tim-fan/vio_hardware/doc/rovio_trajectory_300m.png

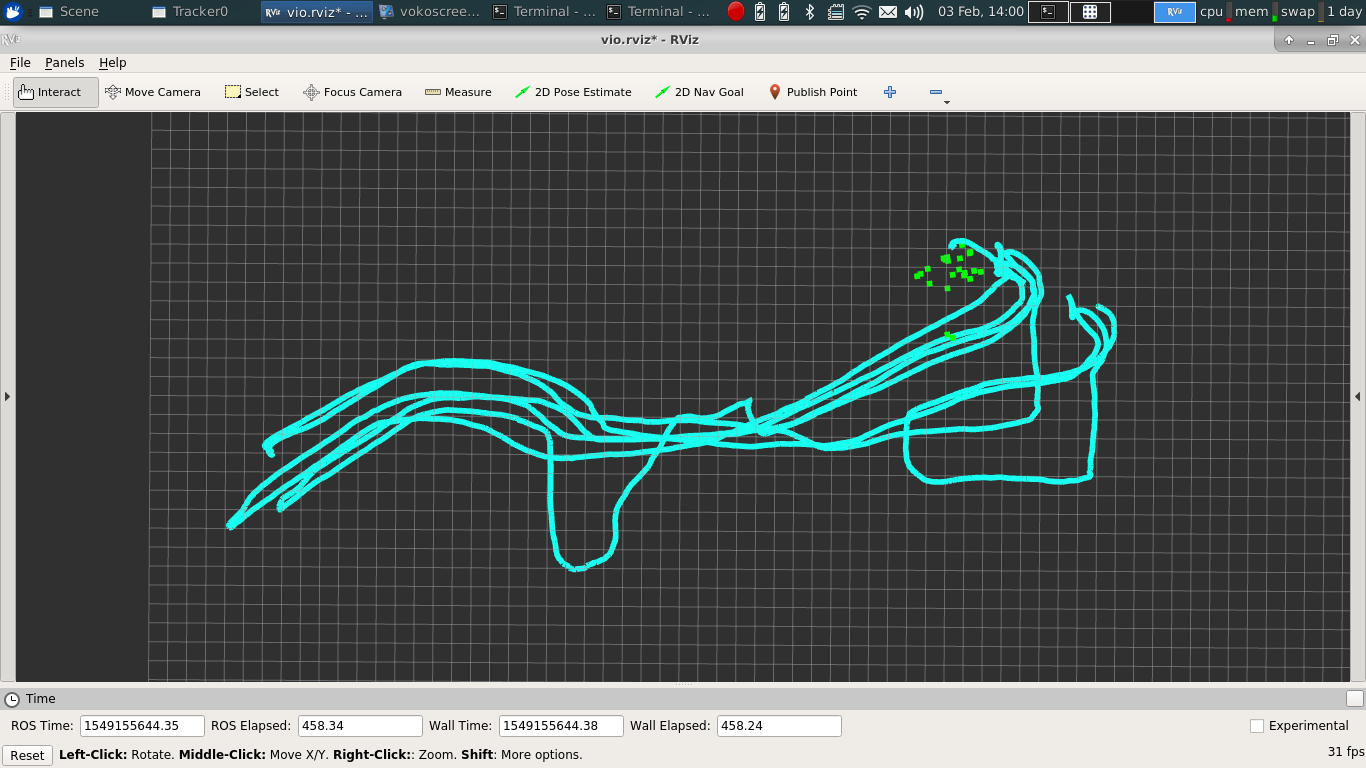
doc/rovio_trajectory_300m.png
