tim-fan/vio_hardware/doc/timestamp_corrections.png

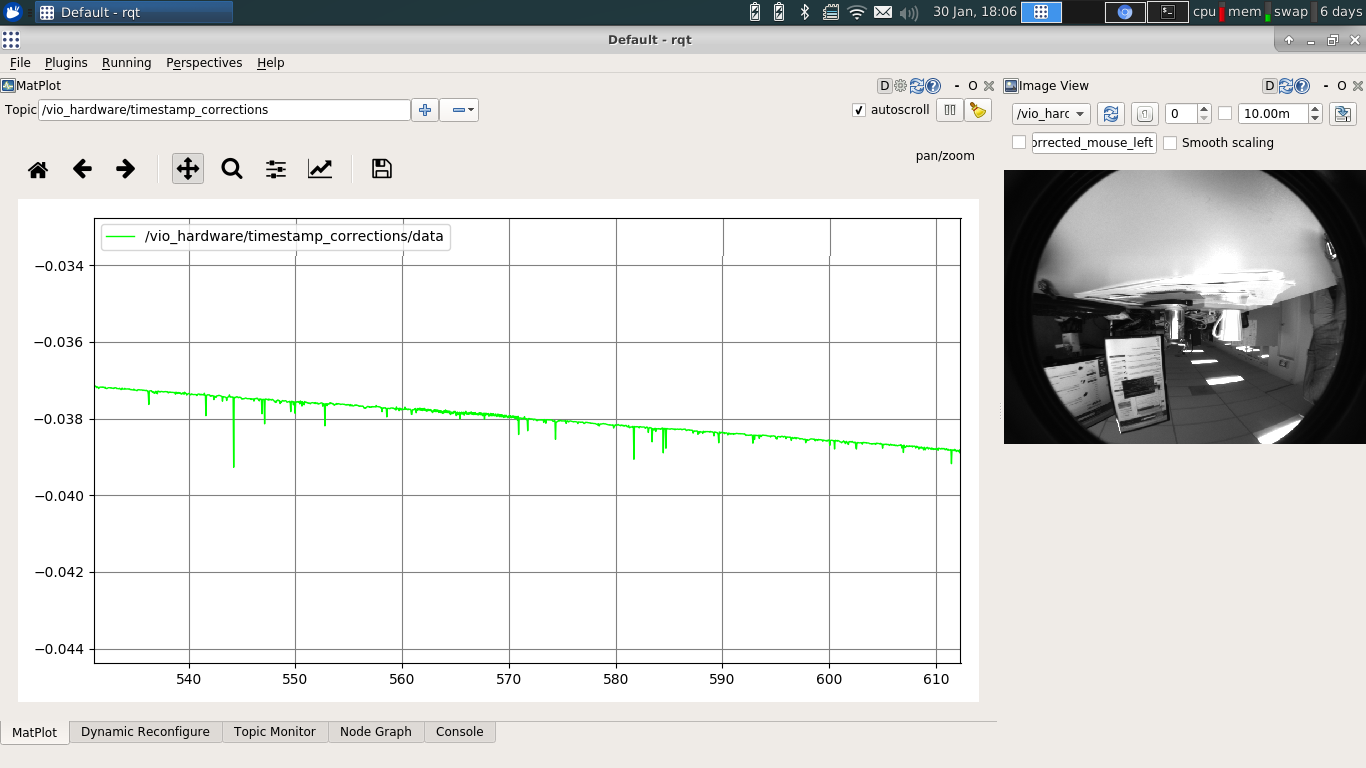
doc/timestamp_corrections.png
