tim-fan/vio_hardware/doc/kalibr_results/report-cam-vio_calibration_log_2019-02-01-18-13-28.pdf

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

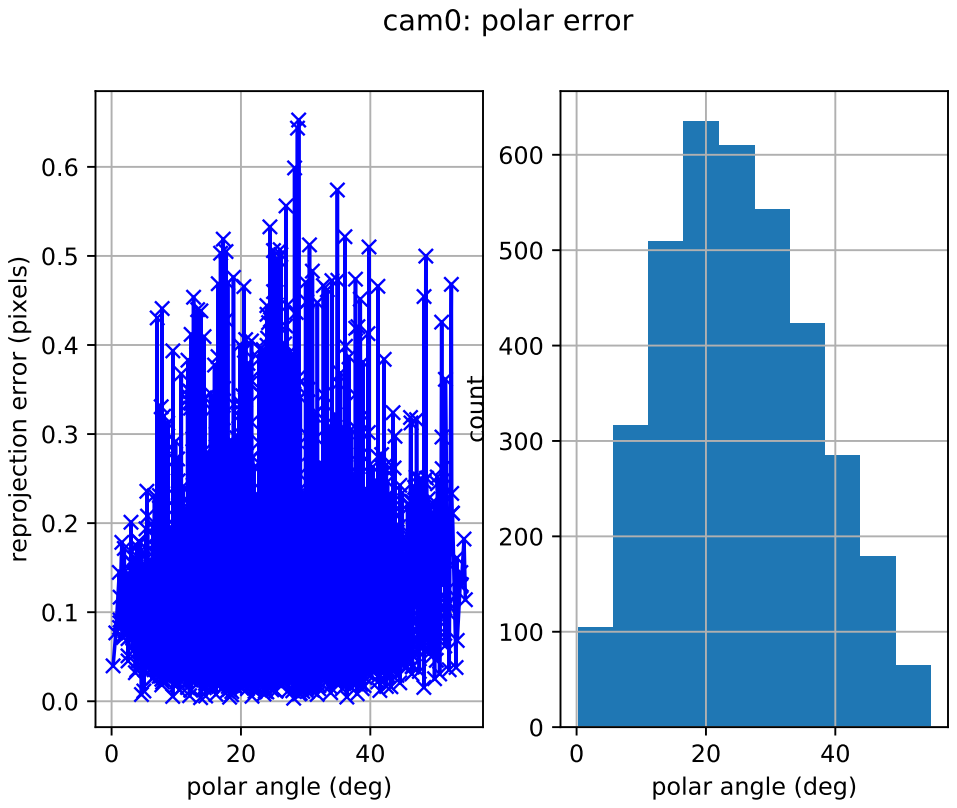
[picture p5: page 1]

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

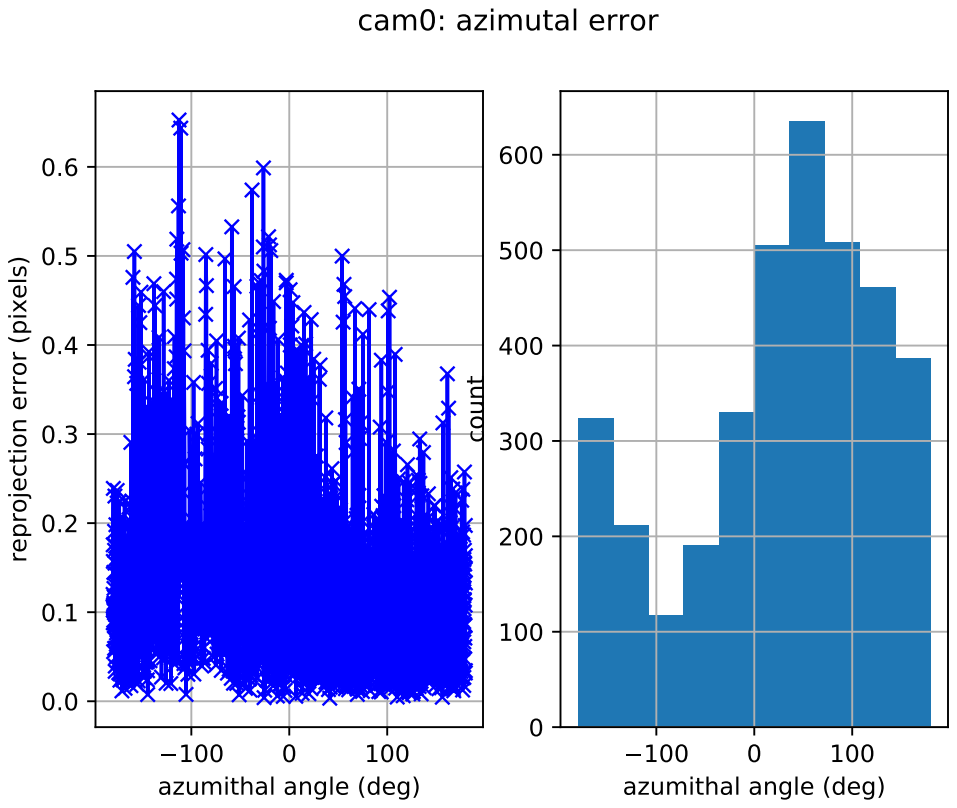
[picture p6: page 2]

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

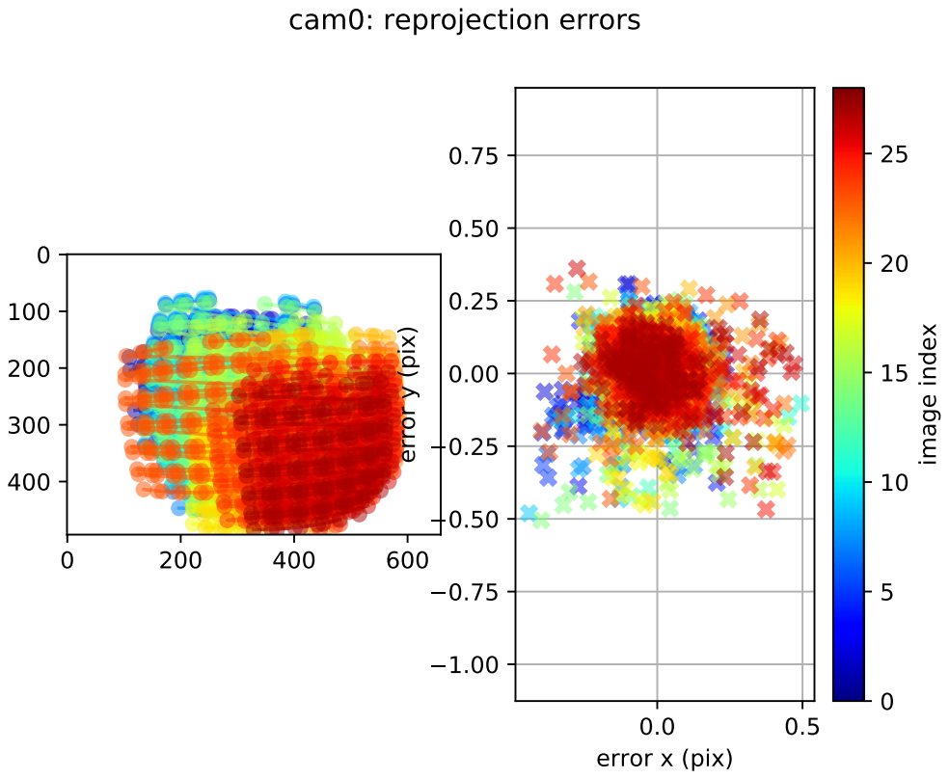
[picture p7: page 3]

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

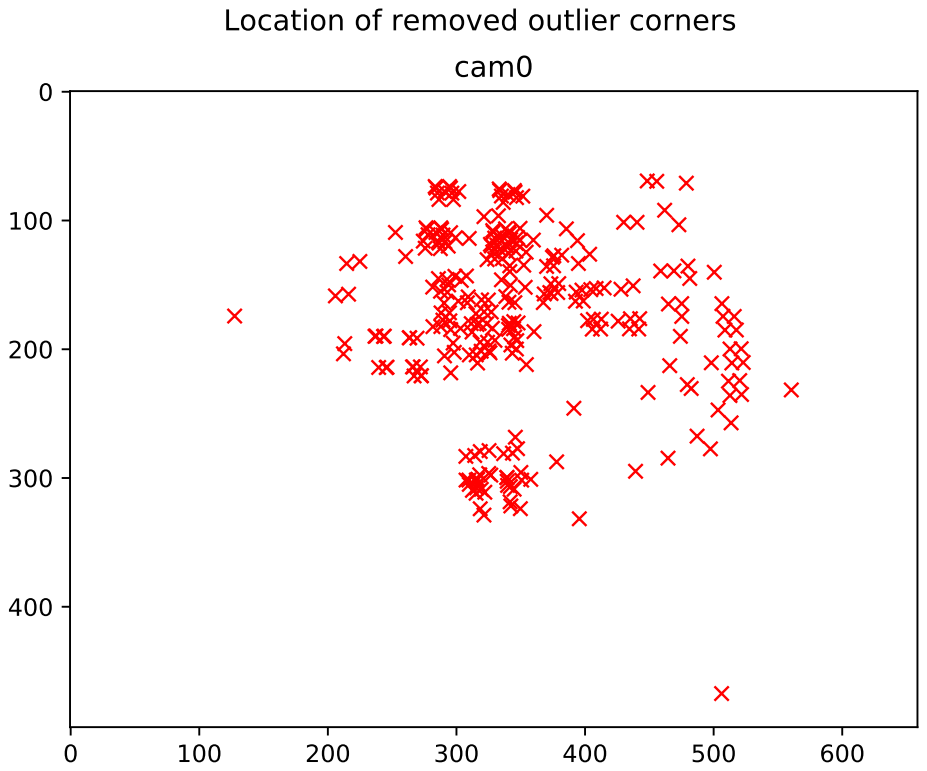
[picture p8: page 4]
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
