tim-fan/vio_hardware/(commit log)

2019-01-28 Initial commit, contains camera/arduino launch and timestamp matcher script
2019-01-28 Commited arduino sketch for vio_timestamper
2019-01-28 Added sketch for imu calibration
2019-01-28 added results from initial calibration with kalibr
2019-01-30 Fixed bug timestamping imu in arduino sketch
    [vio_timetamper.ino]
2019-02-02 Added results from kalibr camer cal
    [camchain-vio_calibration_log_2019-02-01-18-13-28.yaml]
2019-02-02 Added results from kalibr camera-imu cal
    [camchain-imucam-vio_calibration_log_2019-02-01-18-13-28.yaml, imu-vio_calibration_log_2019-02-01-18-13-28.yaml]
2019-02-02 Added autgenerated maplab config
    [sensors-vio_calibration_log_2019-02-01-18-13-28.yaml]
2019-02-02 reorganised maplab config into expected files/formats
    [ncamera_calibration.yaml, sensors-vio_calibration_log_2019-02-01-18-13-28.yaml]
